kmio42/binaryclock/software/wifiExtension/README.md

# Compile Options for ESP8266 (in Arduino environment):
 * ESP8266 Boards v2.6
 * Flash Size: `1MB (FS:none OTA:~502KB)`
 * Reset Mode: `no dtr, no_sync` (only for UART Upload)
 * Debug Port: `disabled`
 * Debug Level: `none`
 * IwIP Variant: `v2 Higher Bandwidth` (increase MSS, overcome some issues with GET requests)
 * Espressif FW: `nonos-sdk 2.2.1+111`
