kmio42/binaryclock/rendering_back.png

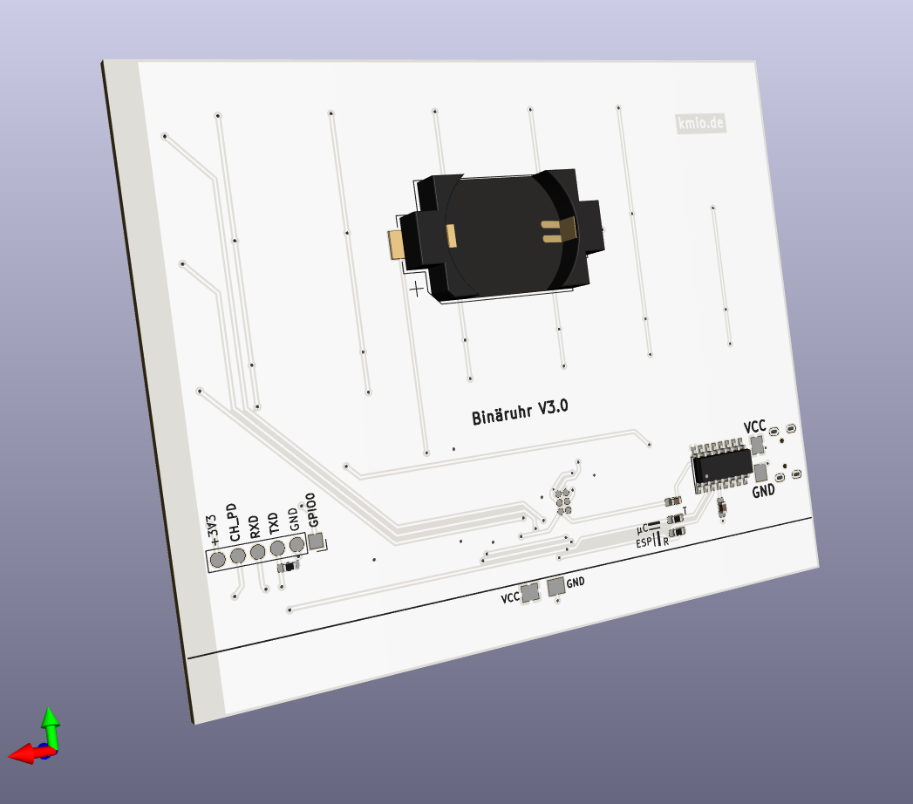
rendering_back.png
