kmio42/binaryclock/rendering_front.png

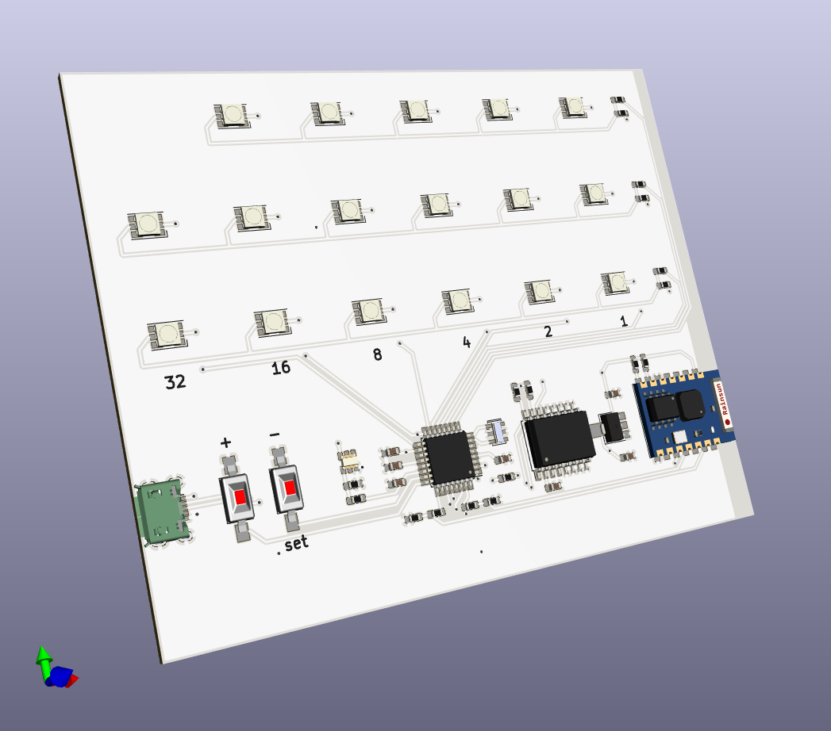
rendering_front.png
