kmio42/binaryclock/hardware/assembly.pdf

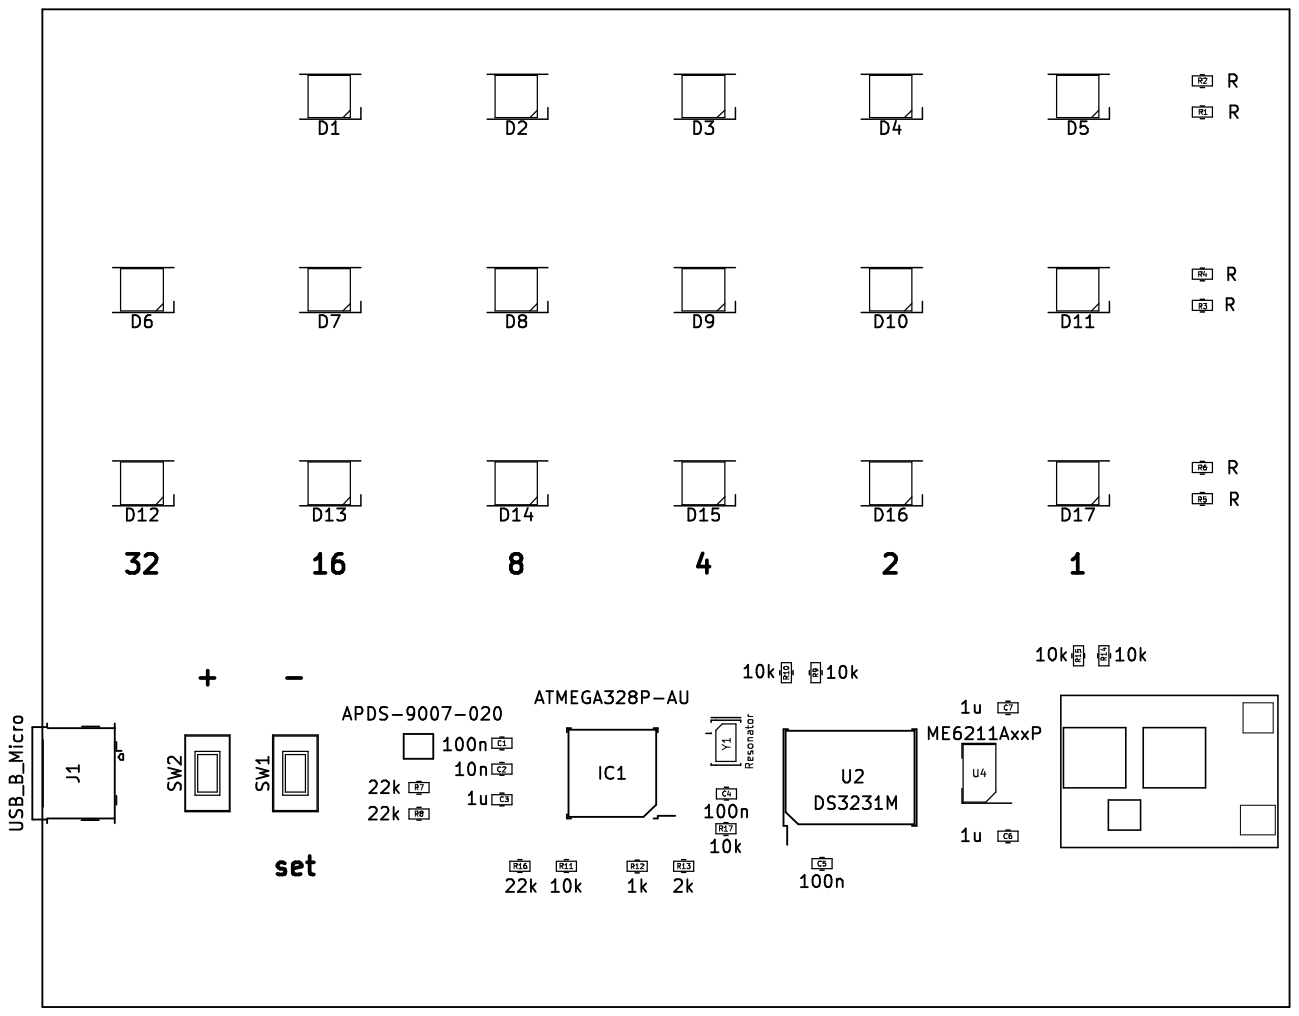
[picture p4: page 1]

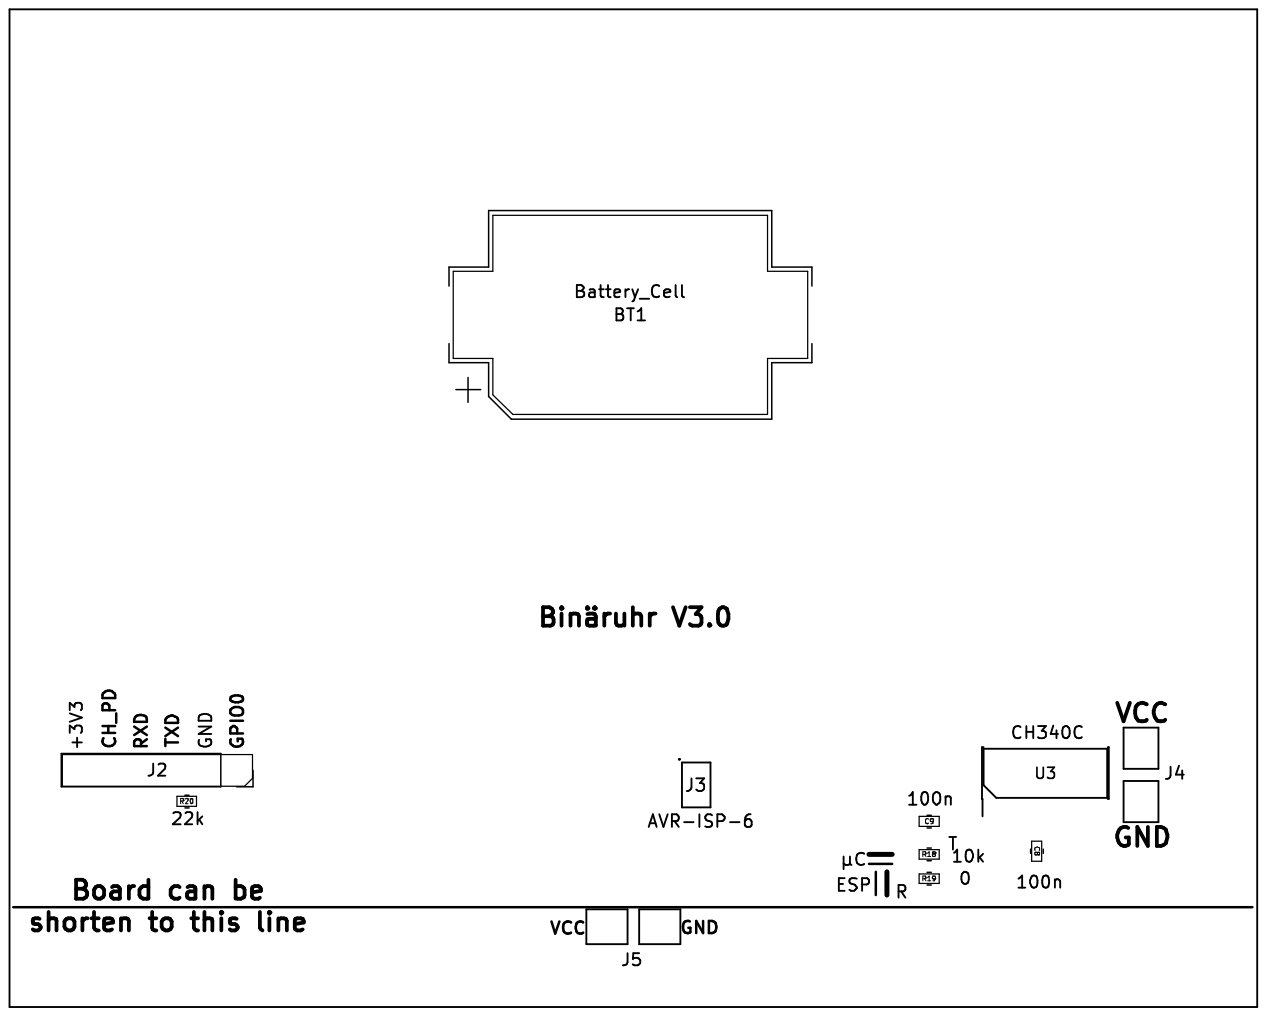
[picture p5: page 2]
