kmio42/binaryclock/hardware/schematic.pdf

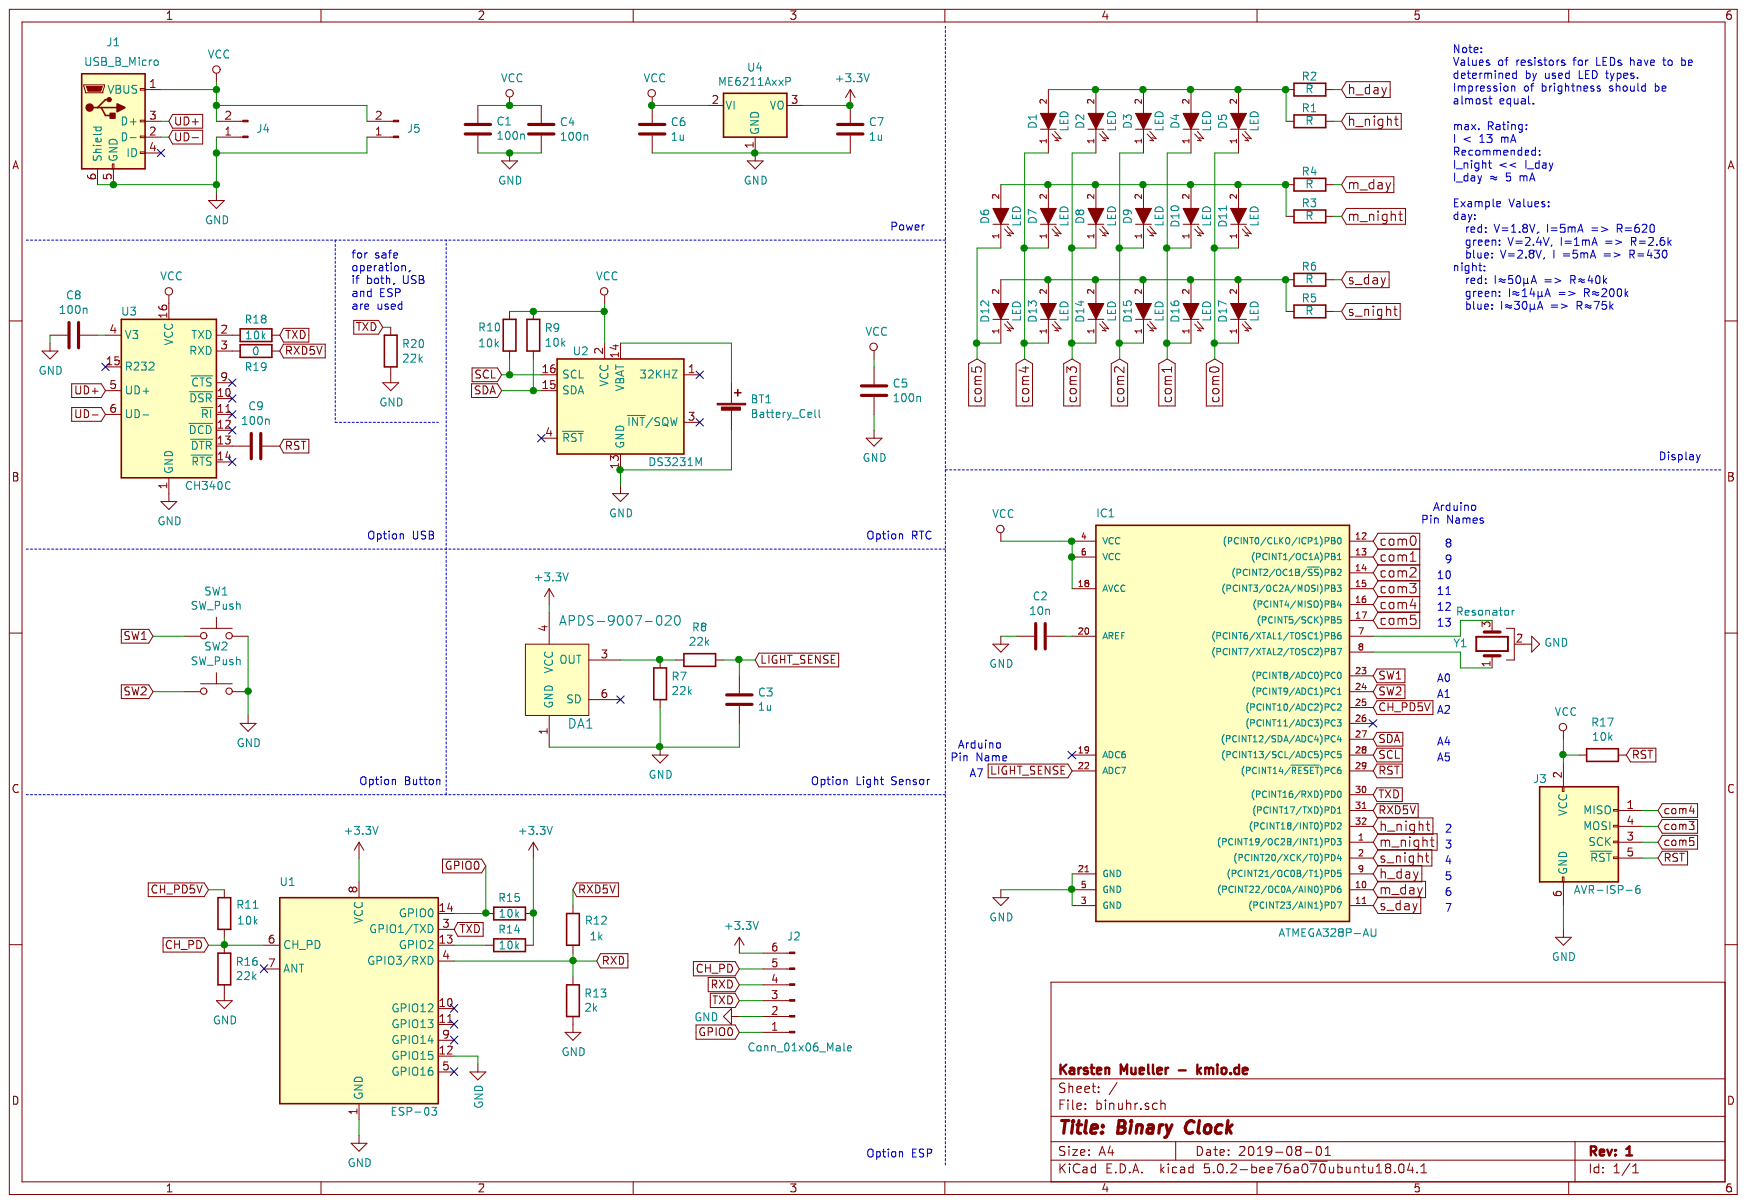
[picture p6: page 1]
