kmio42/binaryclock/(commit log)

2019-08-01 add assembly and 3d-view
2019-10-02 update schematic - bugfix uart
